maugsburger/tinyusbmk2/mkii_bot.png

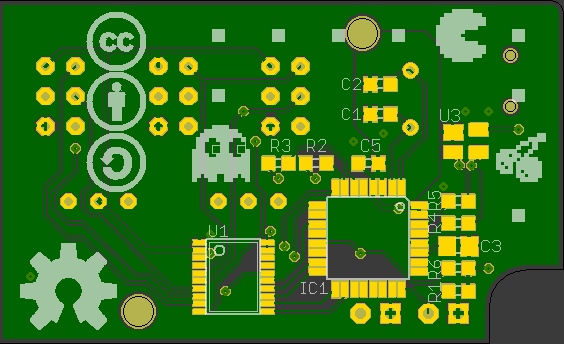
mkii_bot.png
