maugsburger/tinyusbmk2/mkii_sheet1.png

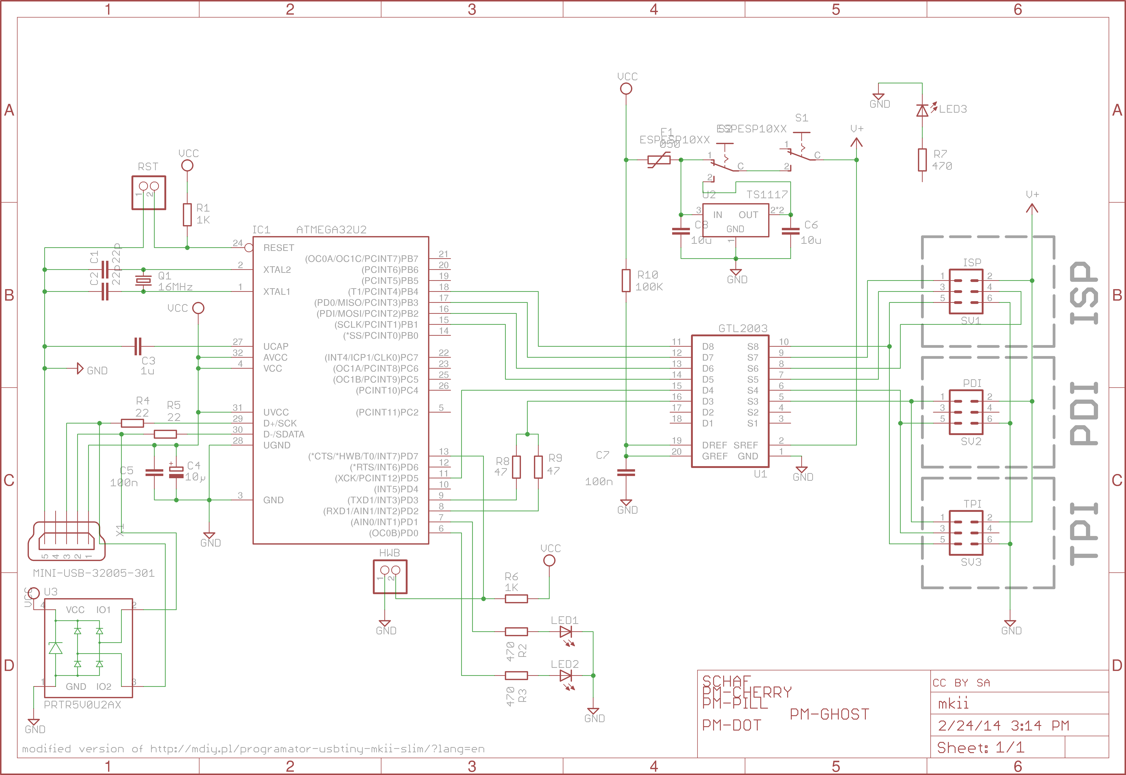
mkii_sheet1.png
