maugsburger/tinyusbmk2/mkii_top.png

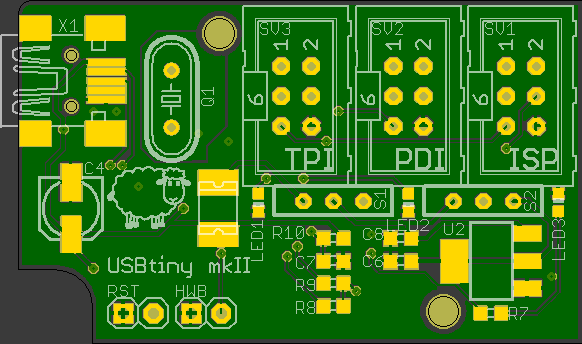
mkii_top.png
