maugsburger/tinyusbmk2/mkii.brd

## EAGLE design mkii.brd (2015-03-31)

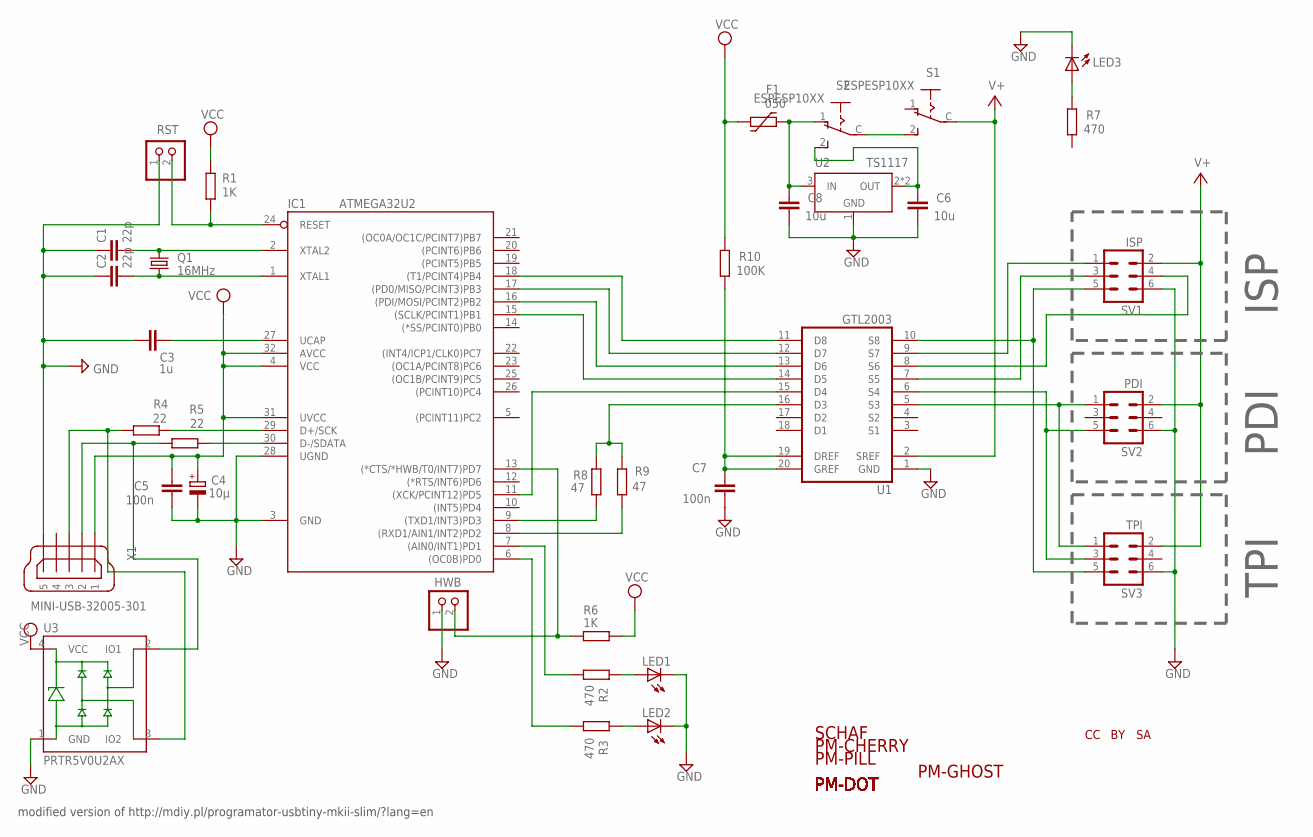
[picture p4: schematic mkii.sch]

Parts:
C1, C2: 22p; C0603
C3: 1u; C0805
C4: 10µ; 153CLV-0505
C5, C7: 100n; C0603
C6, C8: 10u; C0805
F1: 050; 1812L
HWB: PINHD-1X02_2.54-S; 1X02-S
IC1: ATMEGA32U2; TQFP32-08
LED1, LED2, LED3: LEDCHIP-LED0603; CHIP-LED0603
Q1: 16MHz; HC49/S
R1, R6: 1K; R0603
R2, R3, R7: 470; R0603
R4, R5: 22; R0603
R8, R9: 47; R0603
R10: 100K; R0603
RST: PINHD-1X02_2.54-S; 1X02-S
S1, S2: ESPESP10XX; ESP10XX
SV1: ISP; ML6
SV2: PDI; ML6
SV3: TPI; ML6
U1: GTL2003; TSSOP20
U2: TS1117; SOT223
U3: PRTR5V0U2AX; SOT143B
U$1: CC-TPLACE-HALF; CC_TPLACE_HS
U$2: BY-TPLACE-HS; BY_TPLACE_HS
U$3: SA-TPLACE-HALF; SA_TPLACE_HS
U$4: SCHAF7MM; SCHAF-7
U$5: PM-CHERRY5; PM-CHERRY-5
U$6: PM-PILL5; PM-PILL-5
U$8, U$9, U$10, U$11, U$12, U$13, U$14, U$15: PM-DOT5
U$16: PM-GHOSTA5; PM-GHOSTA-5
X1: MINI-USB-32005-301; 32005-301

Connections:
!RST: IC1.24 (RESET), R1.1, RST.2
D+: IC1.29 (D+/SCK), R4.1
D-: IC1.30 (D-/SDATA), R5.1
GND: C1.1, C2.1, C3.1, C4.-, C5.1, C6.1, C7.1, C8.1, HWB.1, IC1.3 (GND), IC1.28 (UGND), LED1.C, LED2.C, LED3.C, RST.1, SV1.6, SV2.6, SV3.6, U1.1 (GND), U2.1 (GND), U3.1 (GND), X1.5
HWB: HWB.2, IC1.13 ((*CTS/*HWB/T0/INT7)PD7), R6.1
unnamed: R4.2, U3.3 (IO2), X1.3
unnamed: S1.2 (S), S2.C
unnamed: IC1.7 ((AIN0/INT1)PD1), R2.2
unnamed: LED3.A, R7.1
unnamed: C8.2, F1.P$2 (2), S2.1 (O), U2.3 (IN)
unnamed: R5.2, U3.2 (IO1), X1.2
unnamed: IC1.9 ((TXD1/INT3)PD3), R8.2
unnamed: IC1.6 ((OC0B)PD0), R3.2
unnamed: LED1.A, R2.1
unnamed: LED2.A, R3.1
unnamed: C7.2, R10.2, U1.19 (DREF), U1.20 (GREF)
unnamed: IC1.18 ((T1/PCINT4)PB4), U1.11 (D8)
unnamed: IC1.17 ((PD0/MISO/PCINT3)PB3), U1.12 (D7)
unnamed: IC1.16 ((PDI/MOSI/PCINT2)PB2), U1.13 (D6)
unnamed: IC1.15 ((SCLK/PCINT1)PB1), U1.14 (D5)
unnamed: IC1.11 ((XCK/PCINT12)PD5), U1.15 (D4)
unnamed: R8.1, R9.1, U1.16 (D3)
unnamed: SV2.1, SV3.1, U1.5 (S3)
unnamed: SV2.5, SV3.3, U1.6 (S4)
unnamed: SV1.5, SV3.5, U1.10 (S8)
unnamed: SV1.1, U1.9 (S7)
unnamed: SV1.4, U1.8 (S6)
unnamed: SV1.3, U1.7 (S5)
unnamed: IC1.8 ((RXD1/AIN1/INT2)PD2), R9.2
unnamed: C6.2, S2.2 (S), U2.2 (OUT), U2.4 (OUT)
UCAP: C3.2, IC1.27 (UCAP)
V+: S1.C, SV1.2, SV2.2, SV3.2, U1.2 (SREF)
VCC: C4.+, C5.2, F1.P$1 (1), IC1.4 (VCC), IC1.31 (UVCC), IC1.32 (AVCC), R1.2, R6.2, R10.1, U3.4 (VCC), X1.1
XTAL1: C2.2, IC1.1 (XTAL1), Q1.1
XTAL2: C1.2, IC1.2 (XTAL2), Q1.2

Notes on the sheet:
ISP
PDI
TPI
modified version of http://mdiy.pl/programator-usbtiny-mkii-slim/?lang=en

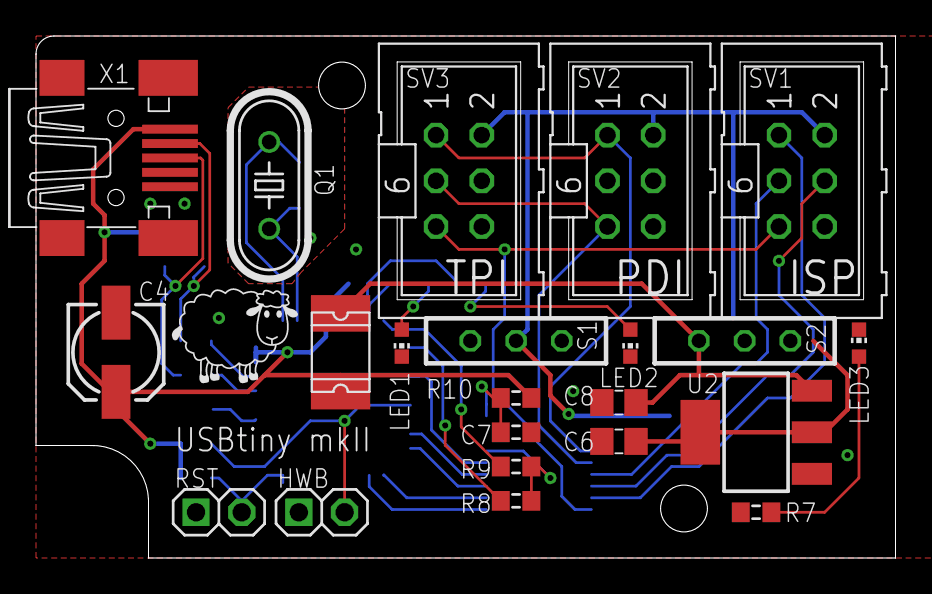
[picture p5: board mkii.brd from above]

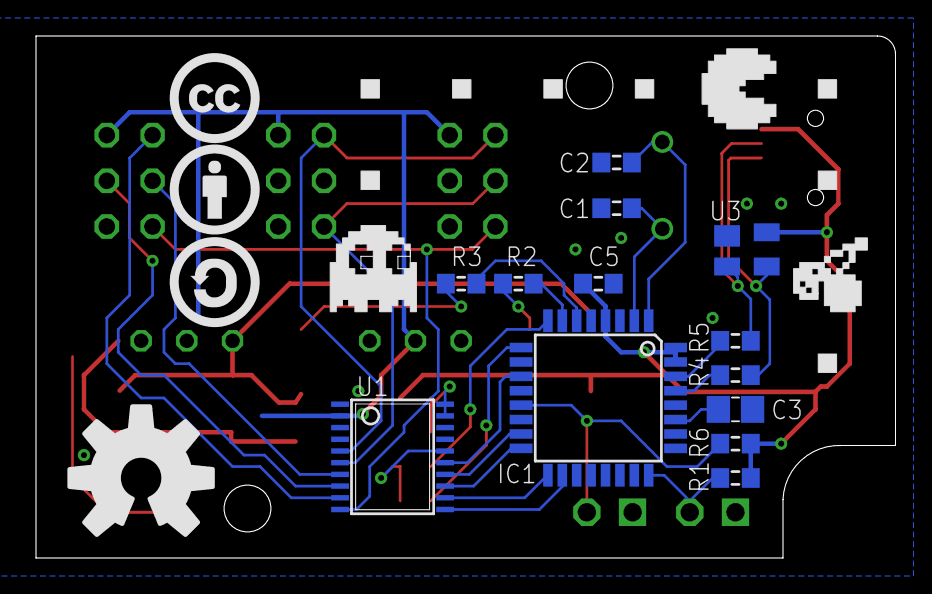
[picture p6: board mkii.brd from below]

Board: 2 copper layers, 47.8 x 29.0 mm, 50 parts (27 on the bottom side), 35 nets.
