maugsburger/tinyusbmk2/(commit log)

2013-09-26 changed led pins, rearranged everyting
    [mkii.brd, mkii.sch]
2013-09-26 align silk screen
    [mkii.brd, mkii.sch]
2013-09-26 sheep power
    [mkii.brd, mkii.sch]
2013-09-27 pacman arrived
    [mkii.brd, mkii.sch]
2013-09-29 more gnd plane between data lines
    [mkii.brd]
2013-09-29 esd supressor for usb
    [mkii.brd, mkii.sch]
2013-10-04 growing sheep
    [mkii.brd, mkii.sch]
2013-10-04 move leds slightly farther away from pin headers
    [mkii.brd]
2013-11-05 atmega32u2, not u4
    [mkii.brd, mkii.sch]
2013-11-05 arranged top/bottom value printout
    [mkii.brd]
2013-11-05 22p cap for crystal
    [mkii.brd, mkii.sch]
2014-02-23 pin4 on usb is id, pin5 is gnd. upstream idiots.
    [mkii.brd, mkii.sch]
2014-02-23 remote circuit on pb5
    can't remember my thoughts – without ADC there is no vbus
    detection.
    [mkii.brd, mkii.sch]
2014-02-24 C6/C8 changed to 0805
    10nF in 0603 is hardly available
    [mkii.brd, mkii.sch]
2015-03-31 unknown changes
    [mkii.brd, mkii.sch]
