maugsburger/tinyusbmk2/(notices)

Notices in the files:
parts and their libraries:
creative-commons: creative commons
Attribution - BY
